IITG-SRC/RISCV_AES_COUNTERMEASURE/Integration_RISCV_Modified_Collatz_Conjecture_Countermeasure/postsynthesis/DBP_BHT.v

					
																				  
			
			 
   
								   
				
					   
				 
				   
				  
				
   
				 
   
			
							   
					   
   
																				  


module DBP_BHT #(
	parameter AWIDTH  = 10,
	parameter DWIDTH = 32
)(
	input clk,
	input reset,

	input  [AWIDTH-1:0] add1,
										 
	output [DWIDTH-1:0] rdata1,
	
	input  [AWIDTH-1:0] add2,
	output [DWIDTH-1:0] rdata2,
	input               wen2,
	input  [DWIDTH-1:0] wdata2
);
								  
										  

	localparam DEPTH = 2**AWIDTH ; 
	
	reg [DWIDTH-1:0] ram_memory [DEPTH-1:0];
	
	//initial $readmemh("C:/Users/mathe/Desktop/hex_file_42clk aes/bht_init.hex",ram_memory);
	//initial $readmemh("./bht_init.hex",ram_memory);
	initial $readmemh("./bht_init_old.hex",ram_memory);
	
 
	// localparam DWIDTH1 = DWIDTH -1 ;
	// genvar i;
	// generate // optional if > *-2001
	// for (i=0; i<DEPTH ; i=i+1) begin 
		// initial ram_memory[i] <= {DWIDTH{1'b0}} ;
		// // initial ram_memory[i] <= {{DWIDTH1{1'b0}}, 1'b1} ;
	// end
	// endgenerate
	
//// ----------------------		Channel	1	-------------------- ////
	reg [DWIDTH-1:0] reg_rdata1 ;
	
	always@(posedge clk) begin
	  if   (reset) reg_rdata1 <= 32'd0 ;
	  else         reg_rdata1 <= ram_memory[add1] ;
	end
	
	assign rdata1 = reg_rdata1 ;
	
	// always@(posedge clk) if ( !reset & wen1 ) ram_memory[add1] <= wdata1 ;
	
//// ----------------------		Channel	2	-------------------- ////
	reg [DWIDTH-1:0] reg_rdata2 ;
	
	always@(posedge clk) begin
	  if   (reset) reg_rdata2 <= 32'd0 ;
	  else         reg_rdata2 <= ram_memory[add2] ;
	end
	
	assign rdata2 = reg_rdata2;
	
	always@(posedge clk) if ( !reset & wen2 ) ram_memory[add2] <= wdata2 ;
	
endmodule
	
